kpreid/3dp-hyve-case/(commit log)

2017-11-24 Initial commit.
    [Hyve back.scad]
2017-11-24 clearance for components
    [Hyve back.scad]
2017-11-24 Battery dimensions and screw holes.
    [Hyve back.scad]
2017-11-24 Hollow out battery compartment and power jack area.
    [Hyve back.scad]
2017-11-24 Cutout for output jack.
    [Hyve back.scad]
2017-11-24 Tweaks, reduce resolution for build performance.
    [Hyve back.scad]
2017-11-24 Reduce resolution on output jack to make a deliberate hexagon.
    [Hyve back.scad]
2017-11-24 Make bottom sloped.
    [Hyve back.scad]
2017-11-24 Slope interior cavity (breaks battery compartment).
    [Hyve back.scad]
2017-11-24 Unbreak battery compartment.
    [Hyve back.scad]
2017-11-24 Tweak corner resolution again.
    [Hyve back.scad]
2017-11-24 Add tolerance for panel fit.
    [Hyve back.scad]
2017-11-24 Remove TODO actually done.
    [Hyve back.scad]
2017-11-24 Round off corners of battery compartment interior.
    This fixes bad geometry between the battery compartment and the panel
    cutout.
    [Hyve back.scad]
2017-11-24 Detailed cutaway on output jack.
    [Hyve back.scad]
2017-11-24 Derive instead of defining bat_wiring_width.
    [Hyve back.scad]
2017-11-24 Round corners of battery compartment opening.
    [Hyve back.scad]
2017-11-24 Slightly fancy edge on battery compartment bump.
    [Hyve back.scad]
2017-11-25 Add options to cut away material for cheaper prototype printing.
    [Hyve back.scad]
2017-12-10 Fix output jack alignment.
    [Hyve back.scad]
2017-12-10 Tweak battery compartment dimensions.
    [Hyve back.scad]
2017-12-10 Set screw hole diameter and fix diameter/radius confusion.
    [Hyve back.scad]
2017-12-10 Cut hole for power switch.
    [Hyve back.scad]
2017-12-10 Cut out extra interior plastic.
    [Hyve back.scad]
2017-12-10 Implement key on switch hole.
    [Hyve back.scad]
2017-12-10 Clearance for "hack" pads and a possible jack or whatever below them.
    [Hyve back.scad]
2017-12-11 Define battery compartment opening separately from battery size.
    This should allow the battery to be actually tilted in with the snap on
    while making it snugger than the previous enlargement.
    [Hyve back.scad]
2017-12-11 Set screw length to 1/4".
    [Hyve back.scad]
2017-12-11 Shrink wiring compartment and back bulge.
    [Hyve back.scad]
2017-12-11 Tweak output jack area.
    [Hyve back.scad]
2017-12-11 Add an option to tilt the model to get a flat bottom.
    [Hyve back.scad]
2018-06-29 Assembly info.
